TiltMeSenpai/mini-mipi/README.md

# mini-mipi
hi github actions (I just needed to kick the plotter script)
