TiltMeSenpai/mini-mipi/mini-mipi.kicad_pcb

## KiCad design mini-mipi.kicad_pcb (2020-08-26)

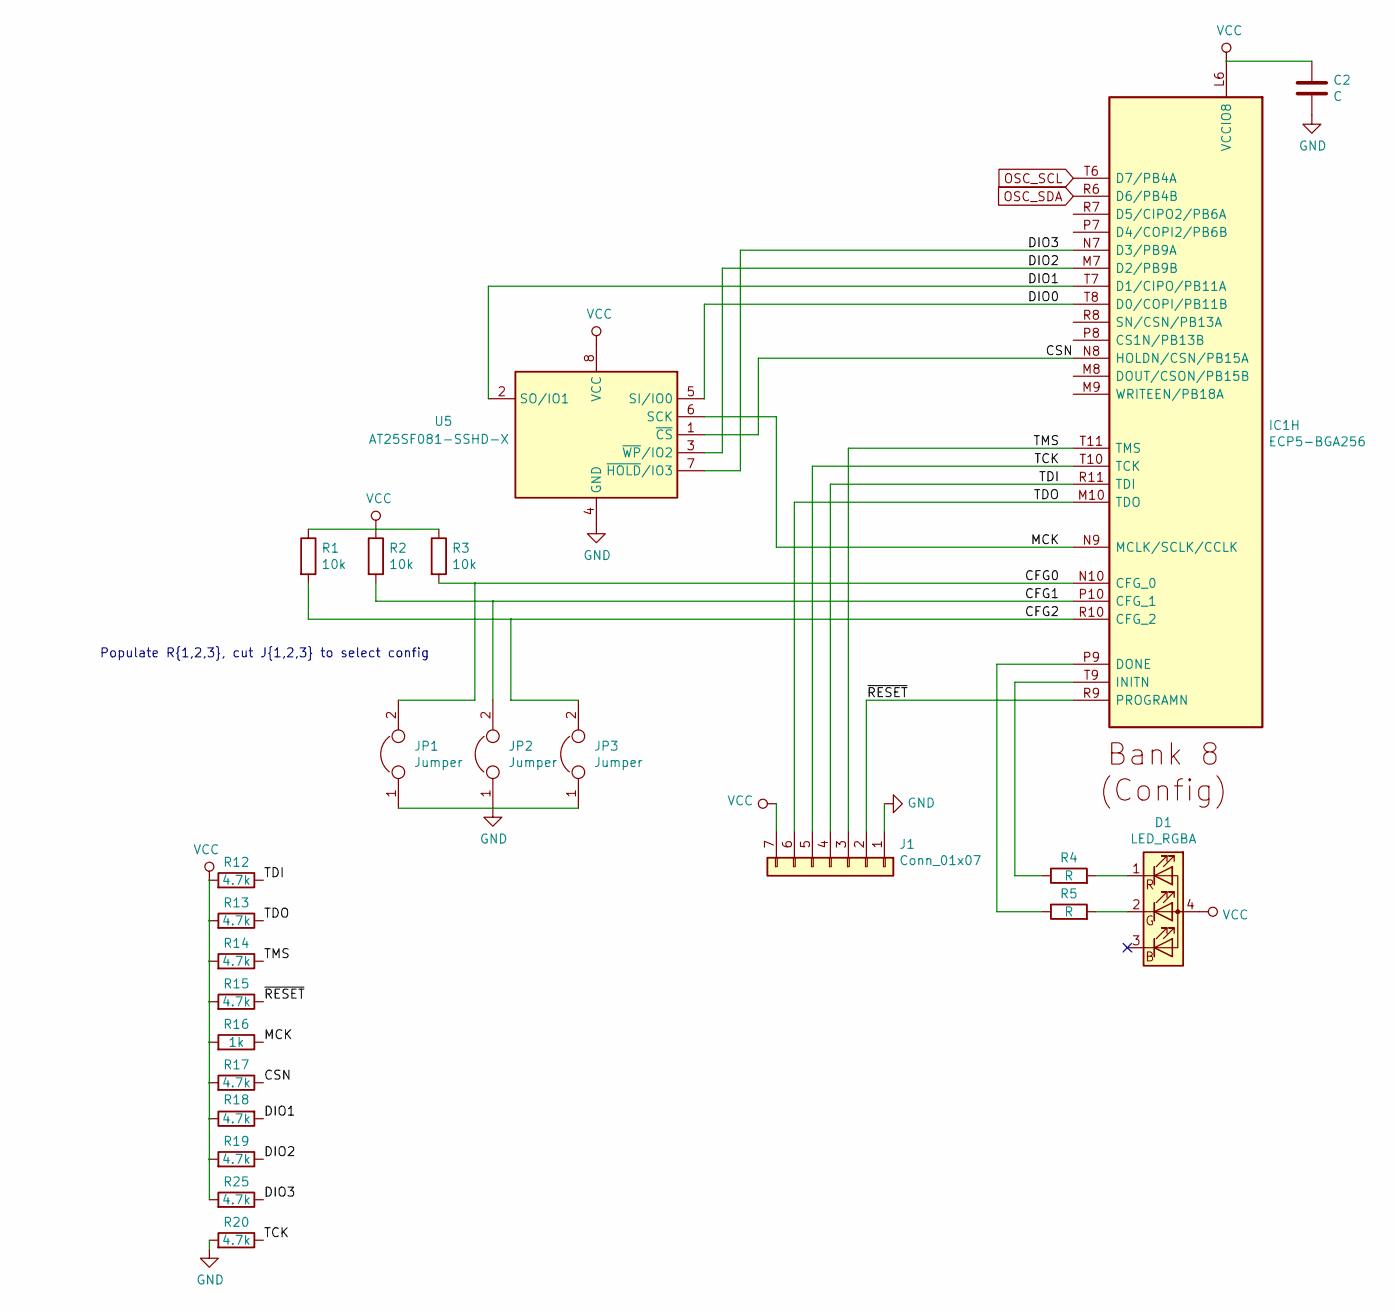
[picture p1: schematic CONFIG.kicad_sch]

Parts:
C2: C; C_0402_1005Metric
D1: LED_RGBA; LED_0404
IC1: ECP5-BGA256; BGA256C80P16X16_1400X1400X170; Manufacturer_Part_Number LFE5U-12F-6BG256C; Mouser Part Number 842-LFE5U12F6BG256C
J1: Conn_01x07; PinHeader_1x07_P2.54mm_Vertical
JP1, JP2, JP3: Jumper; SolderJumper-2_P1.3mm_Bridged_RoundedPad1.0x1.5mm
R1, R2, R3: 10k; R_0402_1005Metric
R4, R5: R; R_0402_1005Metric
R12, R13, R14, R15, R17, R18, R19, R20, R25: 4.7k; R_0402_1005Metric
R16: 1k; R_0402_1005Metric
U5: AT25SF081-SSHD-X; SOIC-8_5.275x5.275mm_P1.27mm

Connections:
/CONFIG/CFG0: IC1.N10 (CFG_0), JP1.2, R3.2
/CONFIG/CFG1: IC1.P10 (CFG_1), JP2.2, R2.2
/CONFIG/CFG2: IC1.R10 (CFG_2), JP3.2, R1.2
/CONFIG/CSN: IC1.N8 (HOLDN/CSN/PB15A), R17.1, U5.1 (~CS)
/CONFIG/DIO0: IC1.T8 (D0/COPI/PB11B), U5.5 (SI/IO0)
/CONFIG/DIO1: IC1.T7 (D1/CIPO/PB11A), R18.2, U5.2 (SO/IO1)
/CONFIG/DIO2: IC1.M7 (D2/PB9B), R19.1, U5.3 (~WP~/IO2)
/CONFIG/DIO3: IC1.N7 (D3/PB9A), R25.1, U5.7 (~HOLD~/IO3)
/CONFIG/MCK: IC1.N9 (MCLK/SCLK/CCLK), R16.1, U5.6 (SCK)
/CONFIG/TCK: IC1.T10 (TCK), J1.5, R20.1
/CONFIG/TDI: IC1.R11 (TDI), J1.4, R12.1
/CONFIG/TDO: IC1.M10 (TDO), J1.6, R13.1
/CONFIG/TMS: IC1.T11 (TMS), J1.3, R14.1
/CONFIG/~RESET: IC1.R9 (PROGRAMN), J1.2, R15.1
GND: C2.2, J1.1, JP1.1, JP2.1, JP3.1, R20.2, U5.4 (GND); also elsewhere on the board
unnamed: D1.1 (RK), R4.2
unnamed: D1.2 (GK), R5.2
unnamed: IC1.P9 (DONE), R5.1
unnamed: IC1.T9 (INITN), R4.1
OSC_SCL: IC1.T6 (D7/PB4A); also elsewhere on the board
OSC_SDA: IC1.R6 (D6/PB4B); also elsewhere on the board
VCC: C2.1, D1.4 (A), IC1.L6 (VCCIO8), J1.7, R1.1, R2.1, R3.1, R12.2, R13.2, R14.2, R15.2, R16.2, R17.2, R18.1, R19.2, R25.2, U5.8 (VCC); also elsewhere on the board

Notes on the sheet:
Populate R{1,2,3}, cut J{1,2,3} to select config

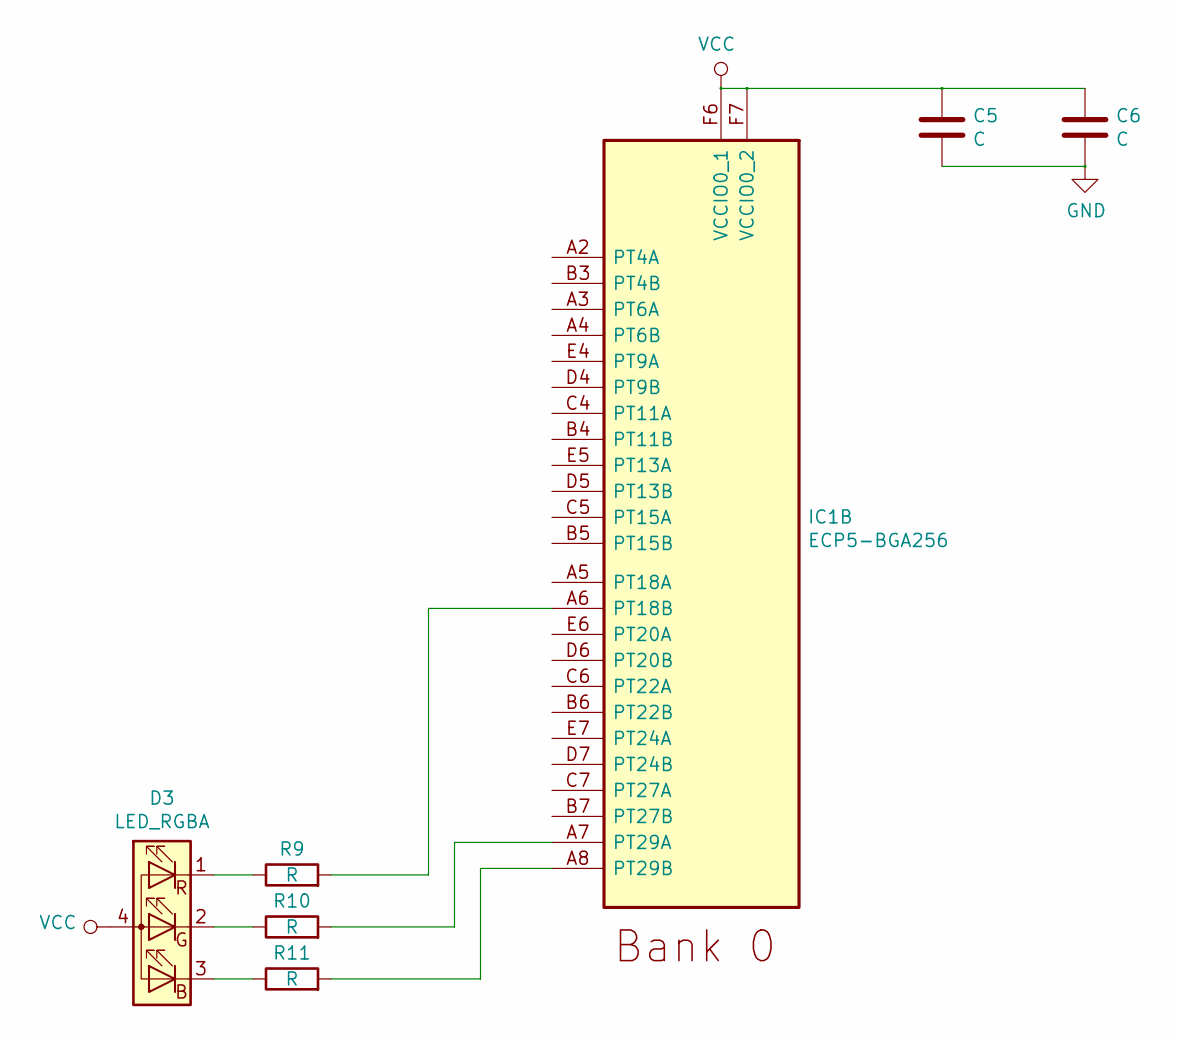
[picture p2: schematic GPIO.kicad_sch]

Parts:
C5, C6: C; C_0402_1005Metric
D3: LED_RGBA; LED_0404
IC1: ECP5-BGA256; BGA256C80P16X16_1400X1400X170; Manufacturer_Part_Number LFE5U-12F-6BG256C; Mouser Part Number 842-LFE5U12F6BG256C
R9, R10, R11: R; R_0402_1005Metric

Connections:
GND: C5.2, C6.2; also elsewhere on the board
unnamed: D3.1 (RK), R9.1
unnamed: D3.2 (GK), R10.1
unnamed: D3.3 (BK), R11.1
unnamed: IC1.A6 (PT18B), R9.2
unnamed: IC1.A7 (PT29A), R10.2
unnamed: IC1.A8 (PT29B), R11.2
VCC: C5.1, C6.1, D3.4 (A), IC1.F6 (VCCIO0_1), IC1.F7 (VCCIO0_2); also elsewhere on the board

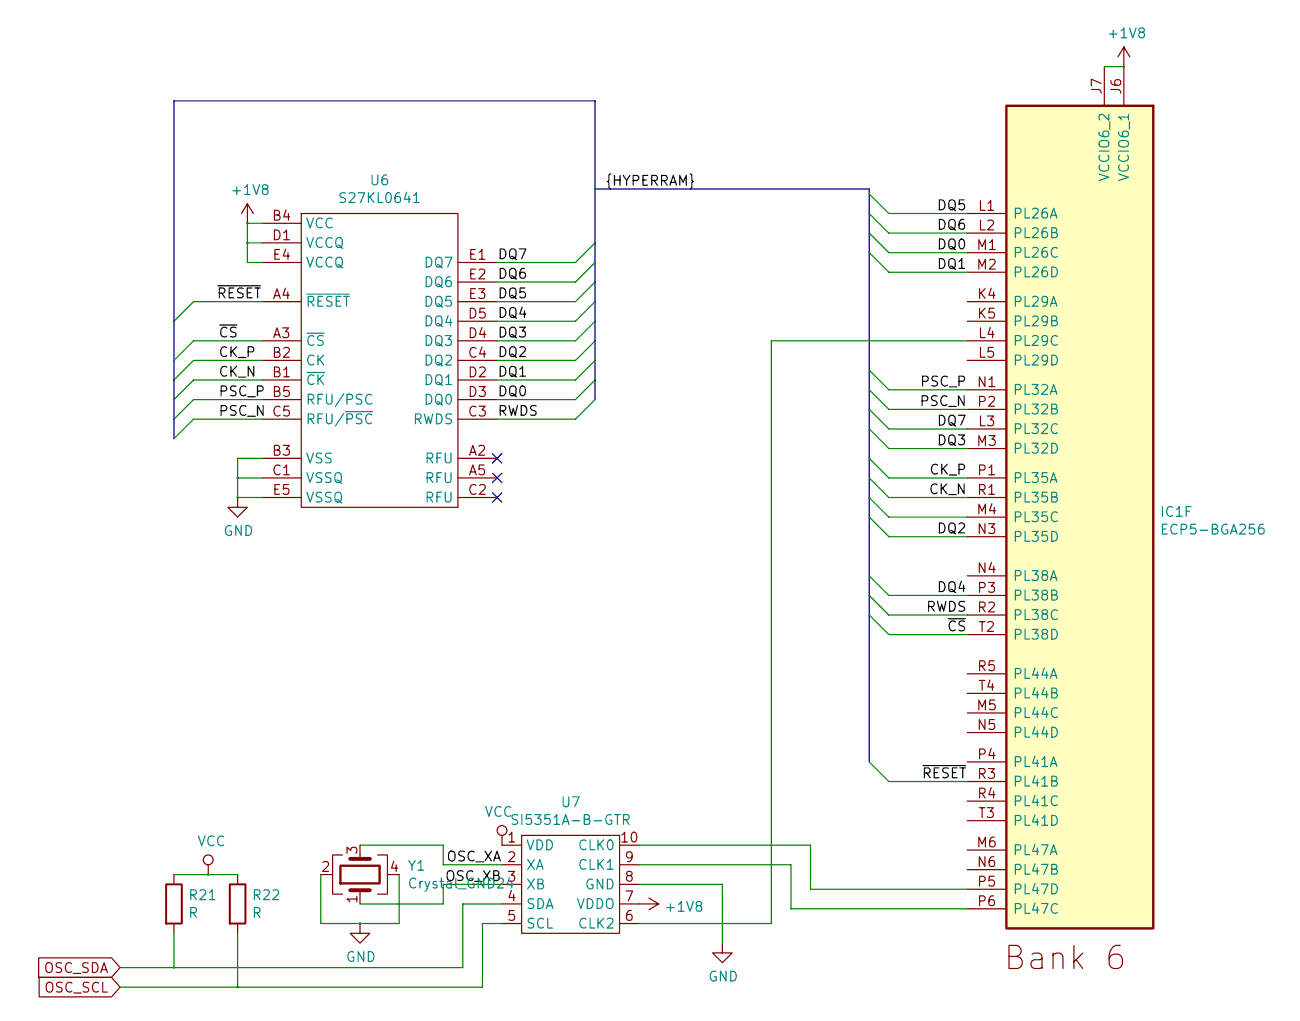
[picture p3: schematic MEMORY.kicad_sch]

Parts:
IC1: ECP5-BGA256; BGA256C80P16X16_1400X1400X170; Manufacturer_Part_Number LFE5U-12F-6BG256C; Mouser Part Number 842-LFE5U12F6BG256C
R21, R22: R; R_0402_1005Metric
U6: S27KL0641; BGA-24_5x5_6.0x8.0mm
U7: SI5351A-B-GTR; MSOP-10_3x3mm_P0.5mm
Y1: Crystal_GND24; Crystal_SMD_2016-4Pin_2.0x1.6mm

Connections:
+1V8: IC1.J6 (VCCIO6_1), IC1.J7 (VCCIO6_2), U6.B4 (VCC), U6.D1 (VCCQ), U6.E4 (VCCQ), U7.7 (VDDO); also elsewhere on the board
/MEMORY/CK_N: IC1.R1 (PL35B), U6.B1 (~CK)
/MEMORY/CK_P: IC1.P1 (PL35A), U6.B2 (CK)
/MEMORY/DQ0: IC1.M1 (PL26C), U6.D3 (DQ0)
/MEMORY/DQ1: IC1.M2 (PL26D), U6.D2 (DQ1)
/MEMORY/DQ2: IC1.N3 (PL35D), U6.C4 (DQ2)
/MEMORY/DQ3: IC1.M3 (PL32D), U6.D4 (DQ3)
/MEMORY/DQ4: IC1.P3 (PL38B), U6.D5 (DQ4)
/MEMORY/DQ5: IC1.L1 (PL26A), U6.E3 (DQ5)
/MEMORY/DQ6: IC1.L2 (PL26B), U6.E2 (DQ6)
/MEMORY/DQ7: IC1.L3 (PL32C), U6.E1 (DQ7)
/MEMORY/OSC_XA: U7.2 (XA), Y1.3
/MEMORY/OSC_XB: U7.3 (XB), Y1.1
/MEMORY/PSC_N: IC1.P2 (PL32B), U6.C5 (RFU/~PSC)
/MEMORY/PSC_P: IC1.N1 (PL32A), U6.B5 (RFU/PSC)
/MEMORY/RWDS: IC1.R2 (PL38C), U6.C3 (RWDS)
/MEMORY/~CS: IC1.T2 (PL38D), U6.A3 (~CS)
/MEMORY/~RESET: IC1.R3 (PL41B), U6.A4 (~RESET)
GND: U6.B3 (VSS), U6.C1 (VSSQ), U6.E5 (VSSQ), U7.8 (GND), Y1.2, Y1.4; also elsewhere on the board
unnamed: IC1.L4 (PL29C), U7.6 (CLK2)
unnamed: IC1.P5 (PL47D), U7.10 (CLK0)
unnamed: IC1.P6 (PL47C), U7.9 (CLK1)
OSC_SCL: R22.2, U7.5 (SCL); also elsewhere on the board
OSC_SDA: R21.2, U7.4 (SDA); also elsewhere on the board
VCC: R21.1, R22.1, U7.1 (VDD); also elsewhere on the board

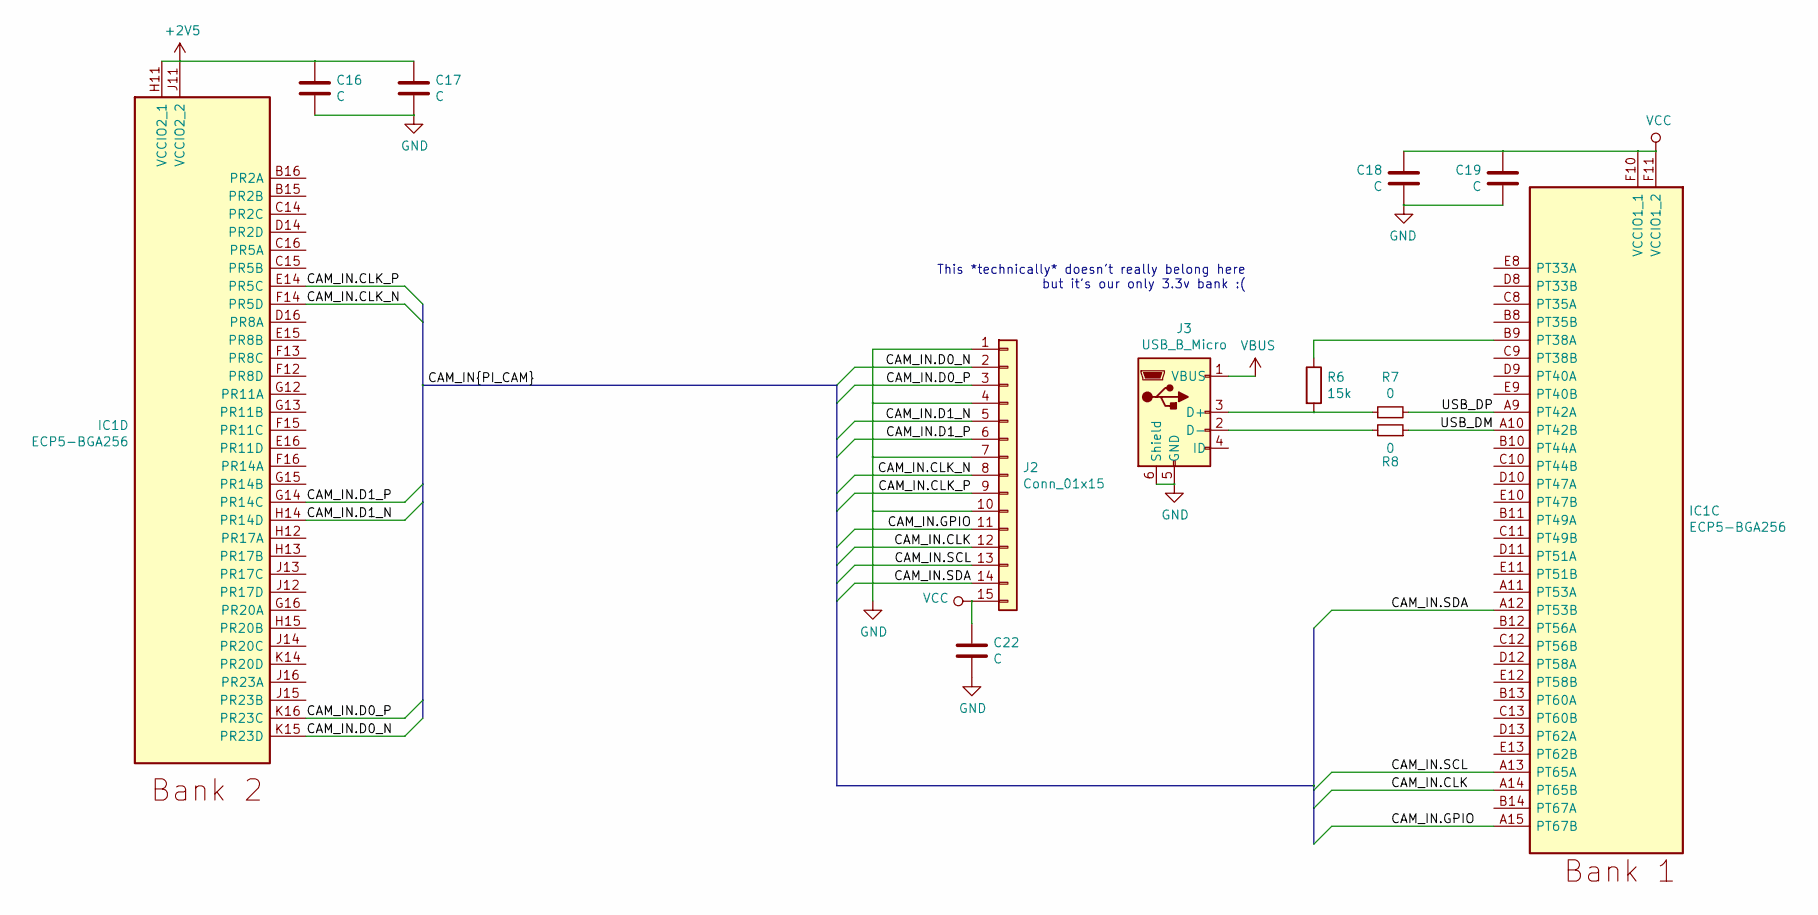
[picture p4: schematic MIPI.kicad_sch]

Parts:
C16, C17, C18, C19: C; C_0402_1005Metric
C22: C; C_0805_2012Metric
IC1: ECP5-BGA256; BGA256C80P16X16_1400X1400X170; Manufacturer_Part_Number LFE5U-12F-6BG256C; Mouser Part Number 842-LFE5U12F6BG256C
J2: Conn_01x15; AMPHENOL_SFW15R-1STE1LF
J3: USB_B_Micro; USB_Micro-B_Wuerth_629105150521
R6: 15k; R_0402_1005Metric
R7, R8: 0; R_0402_1005Metric

Connections:
+2V5: C16.1, C17.1, IC1.H11 (VCCIO2_1), IC1.J11 (VCCIO2_2); also elsewhere on the board
/MIPI/CAM_IN.CLK: IC1.A14 (PT65B), J2.12
/MIPI/CAM_IN.CLK_N: IC1.F14 (PR5D), J2.8
/MIPI/CAM_IN.CLK_P: IC1.E14 (PR5C), J2.9
/MIPI/CAM_IN.D0_N: IC1.K15 (PR23D), J2.2
/MIPI/CAM_IN.D0_P: IC1.K16 (PR23C), J2.3
/MIPI/CAM_IN.D1_N: IC1.H14 (PR14D), J2.5
/MIPI/CAM_IN.D1_P: IC1.G14 (PR14C), J2.6
/MIPI/CAM_IN.GPIO: IC1.A15 (PT67B), J2.11
/MIPI/CAM_IN.SCL: IC1.A13 (PT65A), J2.13
/MIPI/CAM_IN.SDA: IC1.A12 (PT53B), J2.14
/MIPI/USB_DM: IC1.A10 (PT42B), R8.1
/MIPI/USB_DP: IC1.A9 (PT42A), R7.2
GND: C16.2, C17.2, C18.2, C19.2, C22.2, J2.1, J2.4, J2.7, J2.10, J3.5 (GND), J3.6 (Shield); also elsewhere on the board
unnamed: IC1.B9 (PT38A), R6.1
unnamed: J3.2 (D-), R8.2
unnamed: J3.3 (D+), R6.2, R7.1
VBUS: J3.1 (VBUS); also elsewhere on the board
VCC: C18.1, C19.1, C22.1, IC1.F10 (VCCIO1_1), IC1.F11 (VCCIO1_2), J2.15; also elsewhere on the board

Notes on the sheet:
This *technically* doesn't really belong here but it's our only 3.3v bank :(

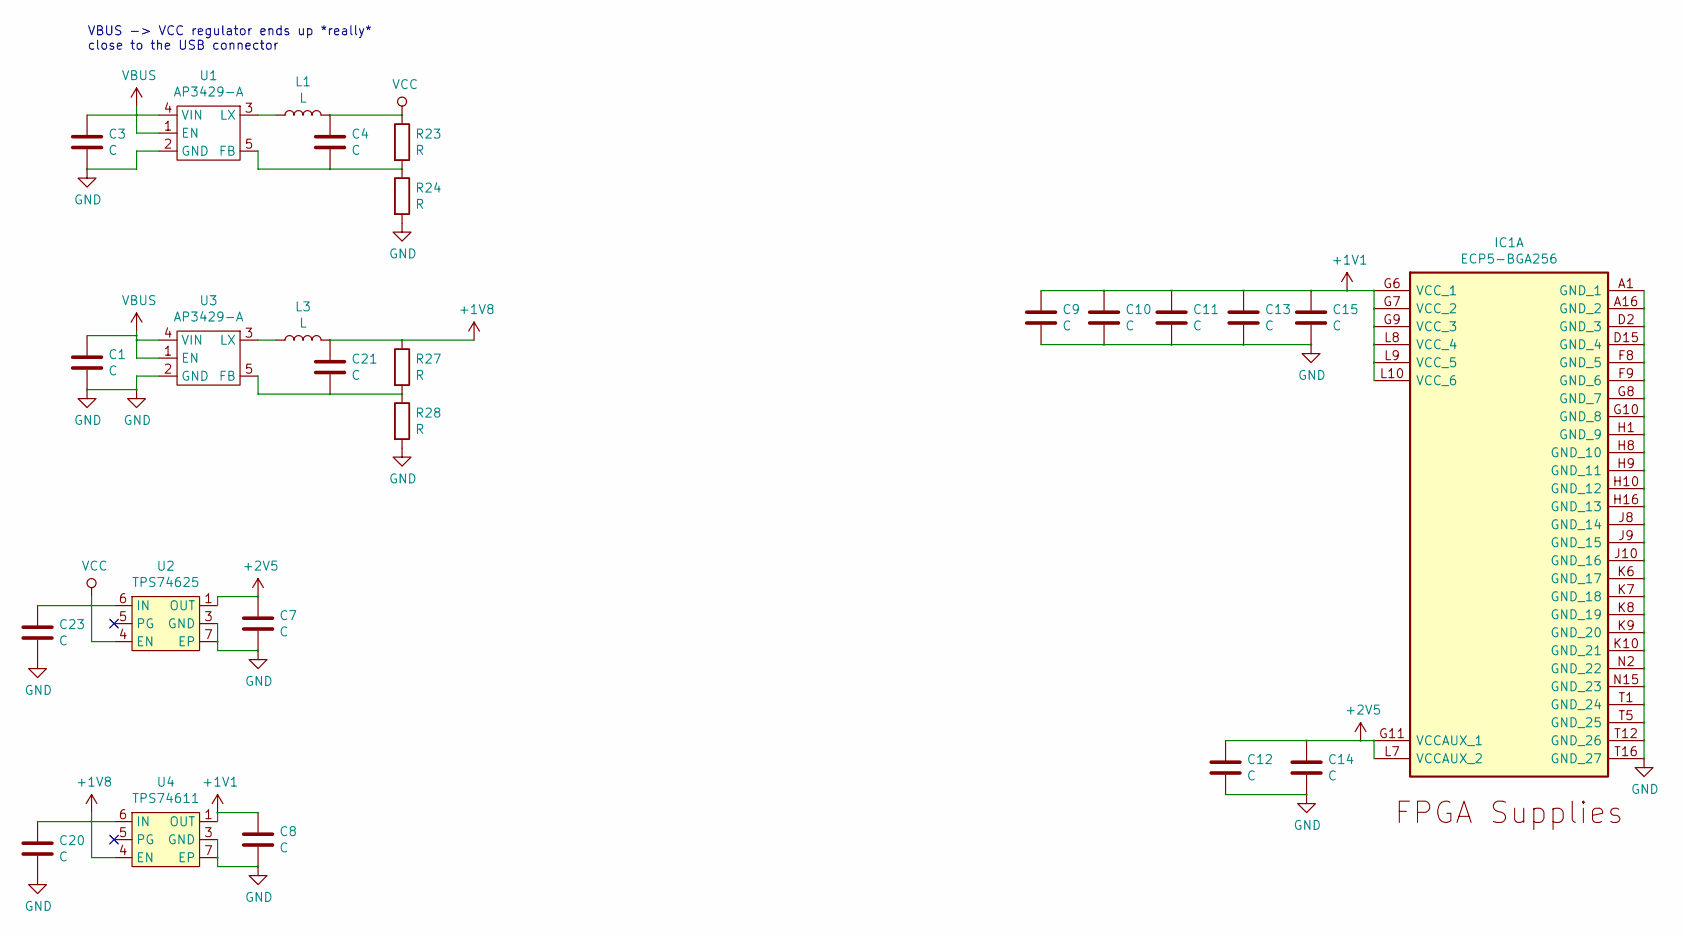
[picture p5: schematic POWER.kicad_sch]

Parts:
C1, C3, C7, C8, C20, C23: C; C_0805_2012Metric
C4, C9, C10, C11, C12, C13, C14, C15, C21: C; C_0402_1005Metric
IC1: ECP5-BGA256; BGA256C80P16X16_1400X1400X170; Manufacturer_Part_Number LFE5U-12F-6BG256C; Mouser Part Number 842-LFE5U12F6BG256C
L1, L3: L; L_1210_3225Metric
R23, R24, R27, R28: R; R_0402_1005Metric
U1, U3: AP3429-A; TSOT-23-5
U2: TPS74625; WSON-6-1EP_2x2mm_P0.65mm_EP1x1.6mm
U4: TPS74611; WSON-6-1EP_2x2mm_P0.65mm_EP1x1.6mm

Connections:
+1V1: C8.1, C9.1, C10.1, C11.1, C13.1, C15.1, IC1.G6 (VCC_1), IC1.G7 (VCC_2), IC1.G9 (VCC_3), IC1.L8 (VCC_4), IC1.L9 (VCC_5), IC1.L10 (VCC_6), U4.1 (OUT)
+1V8: C20.1, C21.1, L3.2, R27.1, U4.4 (EN), U4.6 (IN); also elsewhere on the board
+2V5: C7.1, C12.1, C14.1, IC1.G11 (VCCAUX_1), IC1.L7 (VCCAUX_2), U2.1 (OUT); also elsewhere on the board
GND: C1.2, C3.2, C7.2, C8.2, C9.2, C10.2, C11.2, C12.2, C13.2, C14.2, C15.2, C20.2, C23.2, IC1.A1 (GND_1), IC1.A16 (GND_2), IC1.D2 (GND_3), IC1.D15 (GND_4), IC1.F8 (GND_5), IC1.F9 (GND_6), IC1.G8 (GND_7), IC1.G10 (GND_8), IC1.H1 (GND_9), IC1.H8 (GND_10), IC1.H9 (GND_11), IC1.H10 (GND_12), IC1.H16 (GND_13), IC1.J8 (GND_14), IC1.J9 (GND_15), IC1.J10 (GND_16), IC1.K6 (GND_17), IC1.K7 (GND_18), IC1.K8 (GND_19), IC1.K9 (GND_20), IC1.K10 (GND_21), IC1.N2 (GND_22), IC1.N15 (GND_23), IC1.T1 (GND_24), IC1.T5 (GND_25), IC1.T12 (GND_26), IC1.T16 (GND_27), R24.2, R28.2, U1.2 (GND), U2.3 (GND), U2.7 (EP), U3.2 (GND), U4.3 (GND), U4.7 (EP); also elsewhere on the board
unnamed: C4.2, R23.2, R24.1, U1.5 (FB)
unnamed: C21.2, R27.2, R28.1, U3.5 (FB)
unnamed: L1.1, U1.3 (LX)
unnamed: L3.1, U3.3 (LX)
VBUS: C1.1, C3.1, U1.1 (EN), U1.4 (VIN), U3.1 (EN), U3.4 (VIN); also elsewhere on the board
VCC: C4.1, C23.1, L1.2, R23.1, U2.4 (EN), U2.6 (IN); also elsewhere on the board

Notes on the sheet:
VBUS -> VCC regulator ends up *really* close to the USB connector

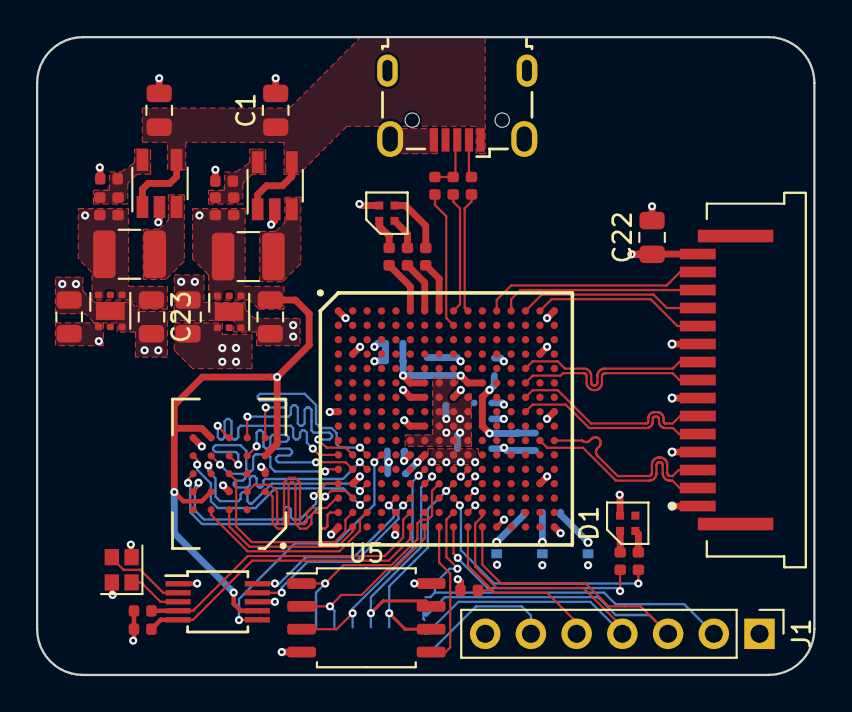
[picture p6: board mini-mipi.kicad_pcb from above]

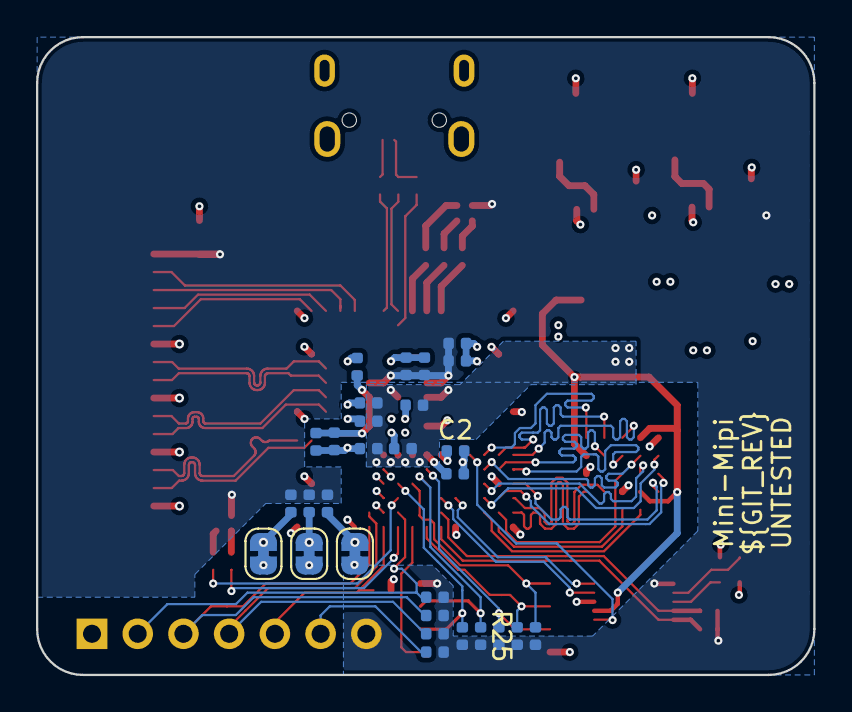
[picture p7: board mini-mipi.kicad_pcb from below]

Board: 4 copper layers, 43.2 x 35.4 mm, 69 parts (29 on the bottom side), 71 nets.
