TiltMeSenpai/mini-mipi/(threads)

Thread 1 (2020-07-22):

Add variable oscillator to board

TiltMeSenpai, 2020-07-22:
USB requires a 48mhz clock, MIPI will probably be easiest to implement with selectable frequencies up to 400mhz.

TiltMeSenpai, 2020-07-22:
Fixed oscillator replaced with SI5153

Closed 2020-07-22.

Thread 2 (2020-07-22):

Change some voltage regulators to buck regulators.

TiltMeSenpai, 2020-07-22:
USB has a max current of 500ma, however the 1.1v rail on the ECP5 can pull >1A. Change some of the regulators in the tree to buck regulators to gain extra amperage on the 1.1v rail.

TiltMeSenpai, 2020-07-22:
Current plan will be to either use a buck regulator on the 5v->3.3 rail, or change the power tree to use a buck regulator from 5v->1.8v, then an LDO from 1.8v to 1.1v.

Closed 2020-07-26.

Thread 3 (2020-07-22):

Bring up R0 boards

TiltMeSenpai, 2020-07-22:
R0 boards have arrived from commit gcc6f230. Bring up boards and create additional issues as found during assembly.

TiltMeSenpai, 2020-07-31:
Voltage rails look good, JTAG looks good. Flash doesn't show SFDP signatures, either missing pullups causing issues or something else?
