TiltMeSenpai/mini-mipi/(commit log)

2020-07-14 Change box around voltage labels
    [CONFIG.kicad_sch, mini-mipi.kicad_pcb, mini-mipi.kicad_sch]
2020-07-14 Add Github Actions config
    [mini-mipi.kicad_pcb]
2020-07-14 Narrow down gerber artifact
2020-07-15 Add semi-critical resistor values
    [CONFIG.kicad_sch, MEMORY.kicad_sch, MIPI.kicad_sch, POWER.kicad_sch, SD_CARD.kicad_sch, mini-mipi.kicad_pcb, mini-mipi.kicad_sch]
2020-07-16 Add more pullup resistors
    [CONFIG.kicad_sch, MEMORY.kicad_sch, MIPI.kicad_sch, POWER.kicad_sch, SD_CARD.kicad_sch, mini-mipi.kicad_pcb, mini-mipi.kicad_sch]
2020-07-16 Remember to save the schematic
    [CONFIG.kicad_sch, mini-mipi.kicad_sch]
2020-07-21 Change oscillator to SI5315, change RGB LED
    [CONFIG.kicad_sch, MEMORY.kicad_sch, MIPI.kicad_sch, POWER.kicad_sch, SD_CARD.kicad_sch, mini-mipi.kicad_pcb, mini-mipi.kicad_sch]
2020-07-23 Change 1.8v and 3.3v regulators to buck for #2
    [CONFIG.kicad_sch, MEMORY.kicad_sch, MIPI.kicad_sch, POWER.kicad_sch, SD_CARD.kicad_sch, mini-mipi.kicad_pcb, mini-mipi.kicad_sch]
2020-07-23 Improve decoupling
    [CONFIG.kicad_sch, POWER.kicad_sch, SD_CARD.kicad_sch, mini-mipi.kicad_pcb, mini-mipi.kicad_sch]
2020-07-31 Change debug header to 2.54mm standard
    [CONFIG.kicad_sch, MEMORY.kicad_sch, MIPI.kicad_sch, POWER.kicad_sch, SD_CARD.kicad_sch, mini-mipi.kicad_pcb, mini-mipi.kicad_sch]
2020-08-16 Remove SD card, relocate regulators
    [CONFIG.kicad_sch, GPIO.kicad_sch, MEMORY.kicad_sch, MIPI.kicad_sch, POWER.kicad_sch, mini-mipi.kicad_pcb, mini-mipi.kicad_sch]
2020-08-26 Fix incorrect flash CSN pin
    [CONFIG.kicad_sch, GPIO.kicad_sch, MEMORY.kicad_sch, MIPI.kicad_sch, POWER.kicad_sch, mini-mipi.kicad_pcb, mini-mipi.kicad_sch]
